adelsonduarte/PonteWheatstonePrecisa/5 - Ponte de Wheastone Precisa/Models/CONSMA020.062-G/CONSMA020.062-G.step

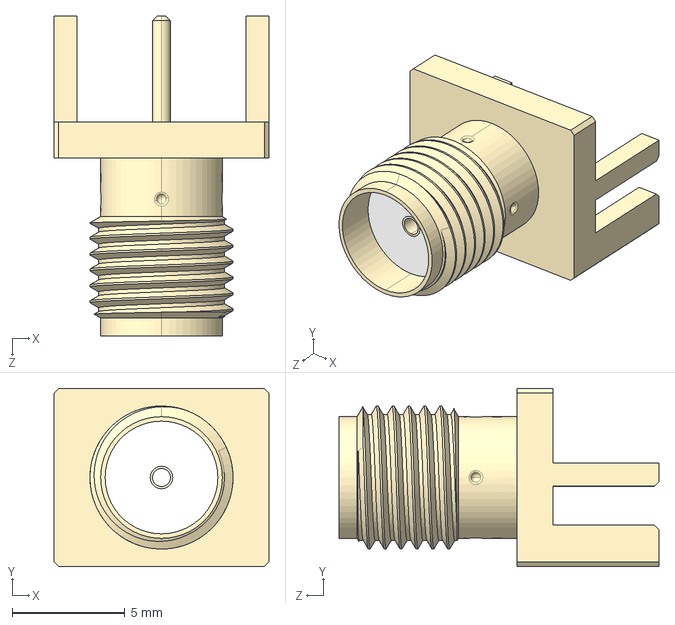
[picture p1: CAD file, 2026-03-06]
5 - Ponte de Wheastone Precisa/Models/CONSMA020.062-G/CONSMA020.062-G.step
9.52 x 7.92 x 14.2 mm

5 - Ponte de Wheastone Precisa/Models/INA333AIDGKR/DGK0008A.stp
4.90 x 3.00 x 1.10 mm
BODY_MUA08A
LEAD_MUA08A x 8
