adelsonduarte/PonteWheatstonePrecisa/5 - Ponte de Wheastone Precisa/Ponte.kicad_pcb

## KiCad design 5 - Ponte de Wheastone Precisa/Ponte.kicad_pcb (2026-03-08)

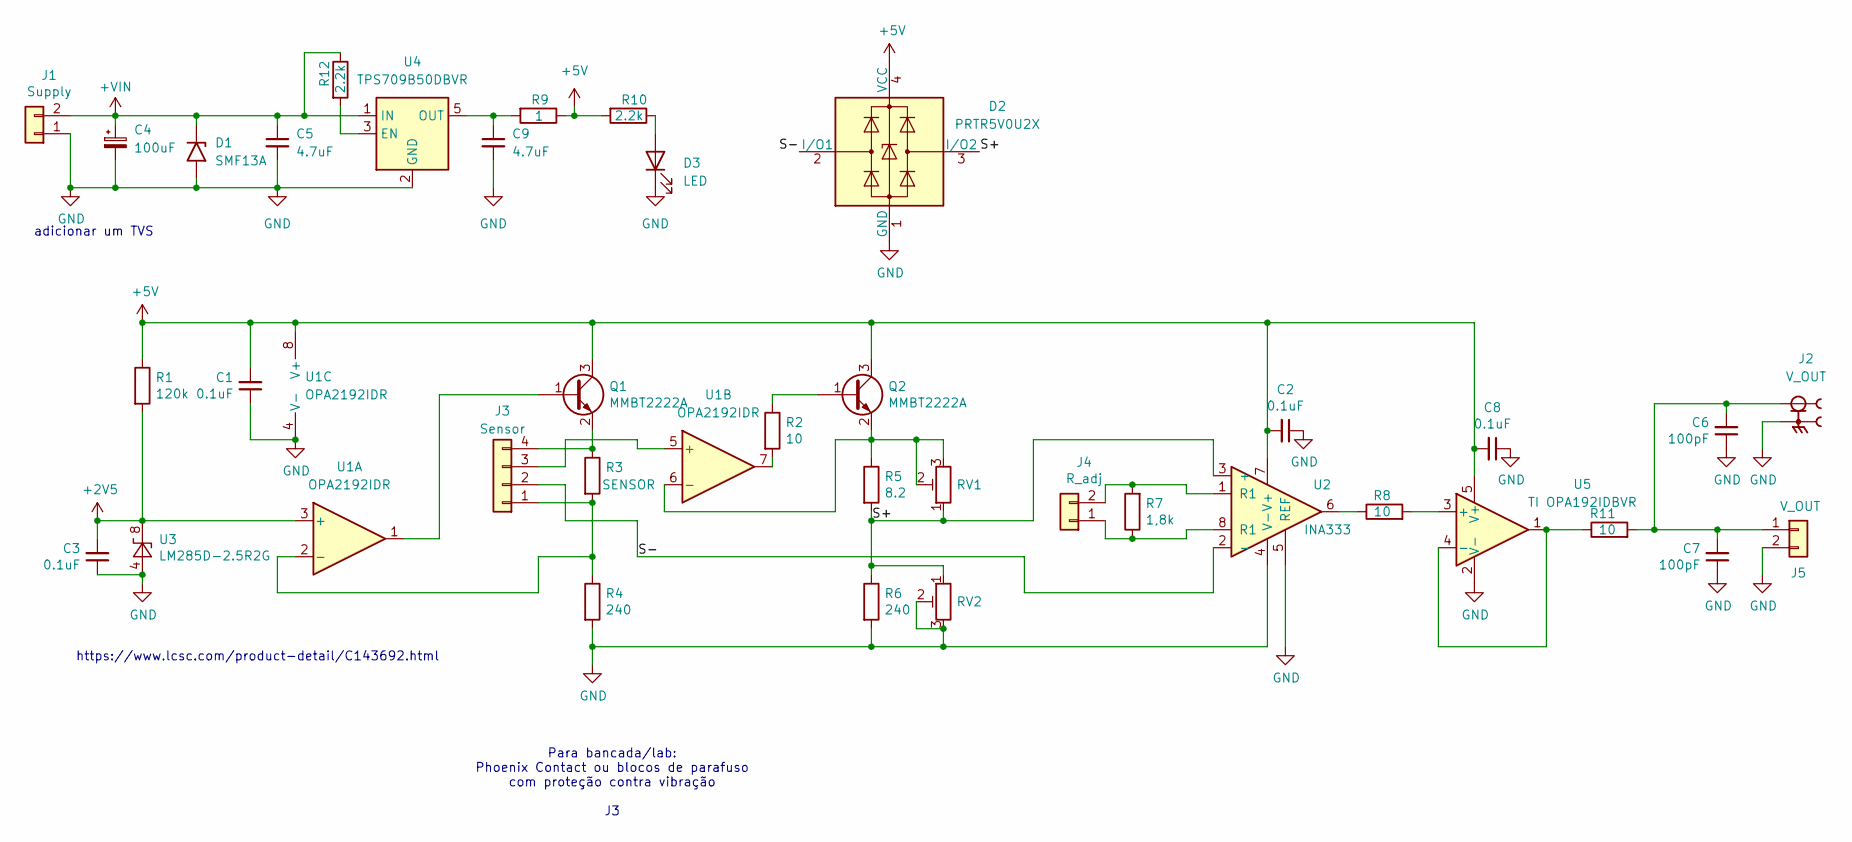
[picture p3: schematic Ponte.kicad_sch]

Parts:
C1, C2, C3, C8: 0.1uF; C_0805_2012Metric_Pad1.18x1.45mm_HandSolder; LCSC part # C519980
C4: 100uF; C_Elec_8x6.2; LCSC part # C88744
C5, C9: 4.7uF; C_0805_2012Metric; LCSC part # C107365
C6, C7: 100pF; C_0805_2012Metric_Pad1.18x1.45mm_HandSolder; LCSC part # C182933
D1: SMF13A; D_SOD-123F; LCSC part # C2857274
D2: PRTR5V0U2X; SOT-143; LCSC part # C2827688
D3: LED; LED_0805_2012Metric; LCSC part # C375451
J1: Supply; Molex_KK-254_AE-6410-02A_1x02_P2.54mm_Vertical; LCSC part # C5447965
J2: V_OUT; LINX_CONSMA020.062-G; PARTREV A
J3: Sensor; Molex_KK-254_AE-6410-04A_1x04_P2.54mm_Vertical; LCSC part # C5447965
J4: R_adj; Molex_KK-254_AE-6410-02A_1x02_P2.54mm_Vertical; LCSC part # C5447965
J5: V_OUT; Molex_KK-254_AE-6410-02A_1x02_P2.54mm_Vertical; LCSC part # C5447965
Q1, Q2: MMBT2222A; SOT-23; LCSC part # C82460
R1: 120k; R_0805_2012Metric_Pad1.20x1.40mm_HandSolder; LCSC part # C304119
R2, R8, R11: 10; R_0805_2012Metric_Pad1.20x1.40mm_HandSolder; LCSC part # C217774
R3: SENSOR; R_0805_2012Metric_Pad1.20x1.40mm_HandSolder
R4, R6: 240; R_0805_2012Metric_Pad1.20x1.40mm_HandSolder; LCSC part # C869301
R5: 8.2; R_0805_2012Metric_Pad1.20x1.40mm_HandSolder; LCSC part # C136890
R7: 1,8k; R_0805_2012Metric_Pad1.20x1.40mm_HandSolder; LCSC part # C375519
R9: 1; R_2512_6332Metric_Pad1.40x3.35mm_HandSolder; LCSC part # C4033338
R10, R12: 2.2k; R_0805_2012Metric; LCSC part # C19269962
RV1, RV2: R_POT_TRIM; Potentiometer_Bourns_3296W_Vertical; LCSC part # C58161
U1: OPA2192IDR; SOIC-8_3.9x4.9mm_P1.27mm; LCSC part # C110074
U2: INA333; VSSOP-8_3x3mm_P0.65mm; LCSC part # C19450
U3: LM285D-2.5R2G; SOIC-8_3.9x4.9mm_P1.27mm; LCSC part # C7931
U4: TPS709B50DBVR; SOT-23-5; LCSC part # C2867109
U5: TI OPA192IDBVR; SOT-23-5; LCSC part # C139648

Connections:
+2V5: C3.2, R1.2, U1.3 (+), U3.8 (K)
+5V: C1.2, C2.2, C8.2, D2.4 (VCC), Q1.3 (C), Q2.3 (C), R1.1, R9.1, R10.2, U1.8 (V+), U2.7 (V+), U5.5 (V+)
+VIN: C4.1, C5.1, D1.1 (A1), J1.2, R12.1, U4.1 (IN)
/S+: D2.3 (I/O2), R5.2, R6.1, RV1.1, RV2.1, U2.3 (+)
/S-: D2.2 (I/O1), J3.2, U2.2 (-)
GND: C1.1, C2.1, C3.1, C4.2, C5.2, C6.1, C7.1, C8.1, C9.2, D1.2 (A2), D2.1 (GND), D3.1 (K), J1.1, J2.S1, J5.2, R4.2, R6.2, RV2.2, RV2.3, U1.4 (V-), U2.4 (V-), U2.5 (REF), U3.4 (A), U4.2 (GND), U5.2 (V-)
unnamed: D3.2 (A), R10.1
unnamed: J3.1, R3.2, R4.1, U1.2 (-)
unnamed: J3.3, U1.5 (+)
unnamed: J3.4, Q1.2 (E), R3.1
unnamed: J4.1, R7.1, U2.8 (R1)
unnamed: J4.2, R7.2, U2.1 (R1)
unnamed: C6.2, C7.2, J2.1, J5.1, R11.2
unnamed: Q1.1 (B), U1.1
unnamed: Q2.1 (B), R2.1
unnamed: Q2.2 (E), R5.1, RV1.2, RV1.3, U1.6 (-)
unnamed: R2.2, U1.7
unnamed: R8.1, U2.6
unnamed: R12.2, U4.3 (EN)
unnamed: C9.1, R9.2, U4.5 (OUT)
unnamed: R8.2, U5.3 (+)
unnamed: R11.1, U5.1, U5.4 (-)

Notes on the sheet:
Para bancada/lab: Phoenix Contact ou blocos de parafuso com proteção contra vibração J3
https://www.lcsc.com/product-detail/C143692.html
adicionar um TVS

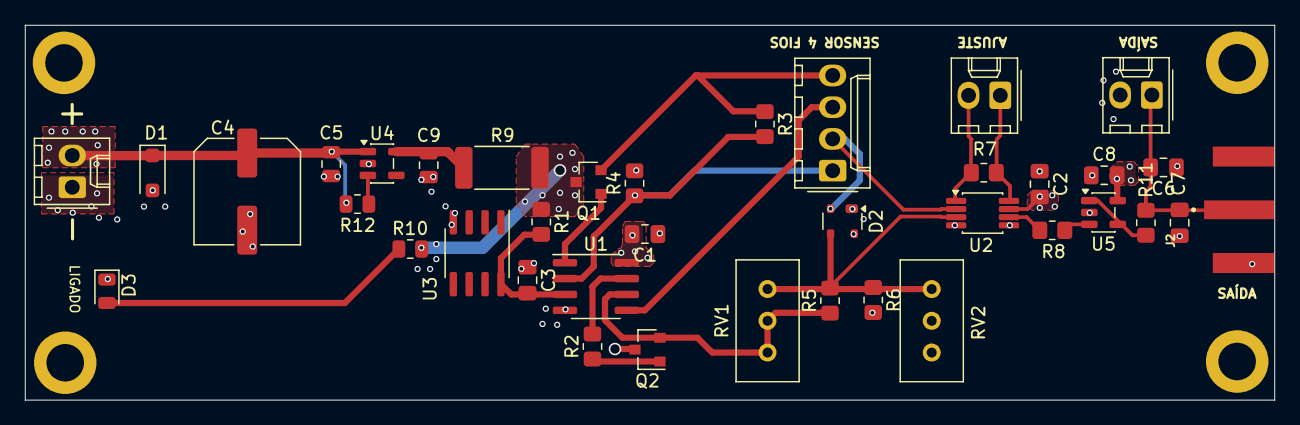
[picture p4: board Ponte.kicad_pcb from above]

Board: 4 copper layers, 100.0 x 30.0 mm, 38 parts (0 on the bottom side), 22 nets.
