adelsonduarte/PonteWheatstonePrecisa/(commit log)

2026-03-06 Esquemático finalizado
    [CONSMA020.062-G.step, Ponte.kicad_pcb, Ponte.kicad_sch, Ponte.sch]
2026-03-06 Adicionado sensor 4 fios; PCB_1
    [Ponte.kicad_pcb, Ponte.kicad_sch]
2026-03-07 Posicionado e roteado. Restando adicionar vias de GND e guard ring.
    [Ponte.kicad_pcb, Ponte.kicad_sch]
2026-03-08 Adicionado silks e furos para suporte. Preço com montagem R04,54
    [BOM-Ponte.csv, DGK0008A.stp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]
